AntonioArceEE/8-Bit-Binary-Adder/(list of files, drawings)

Other design files:
8-Bit-Adder-MultiSim-Simulation.ms14
