AntonioArceEE/8-Bit-Binary-Adder/(commit log)

2026-07-31 Revise README with Arduino details and testing info
    Expanded README to include Arduino integration, detailed circuit operation, testing results, troubleshooting, and future improvements for the 8-bit binary adder project.
2026-07-31 Fix resistor wattage notation in README
2026-08-01 Add Multisim simulation and schematic
    [8-Bit-Adder-MultiSim-Simulation.ms14]
2026-08-01 Fix Multisim simulation and schematic file names
    Corrected file names for Multisim simulation and schematic.
